JanDerogee/SerialSpeechSynthesizerSAM/documentation/Usermanual/instructional_drawings/Arduino_IDE_settings.jpg

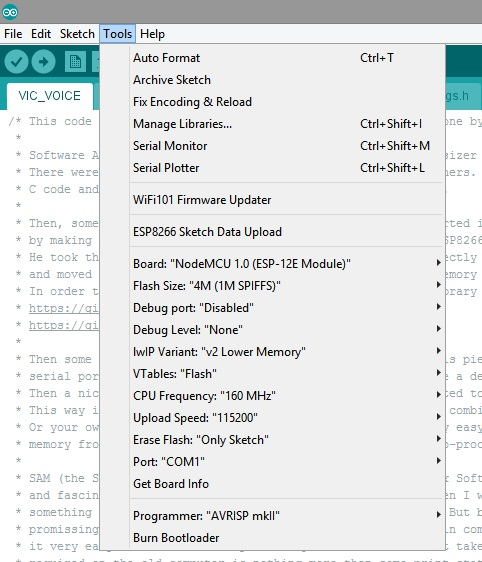
documentation/Usermanual/instructional_drawings/Arduino_IDE_settings.jpg
