JanDerogee/SerialSpeechSynthesizerSAM/Foto's/C64_setup.JPG

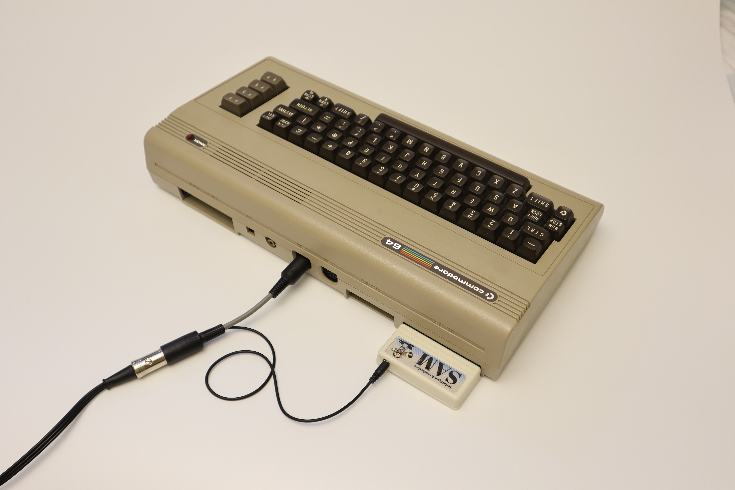
Foto's/C64_setup.JPG
