JanDerogee/SerialSpeechSynthesizerSAM/tools/readme.txt

drop the .jar file in the arduino tools directory

C:\Program Files (x86)\Arduino\tools\ESP8266FS\tool
