JanDerogee/SerialSpeechSynthesizerSAM/Foto's/DSC03284.JPG

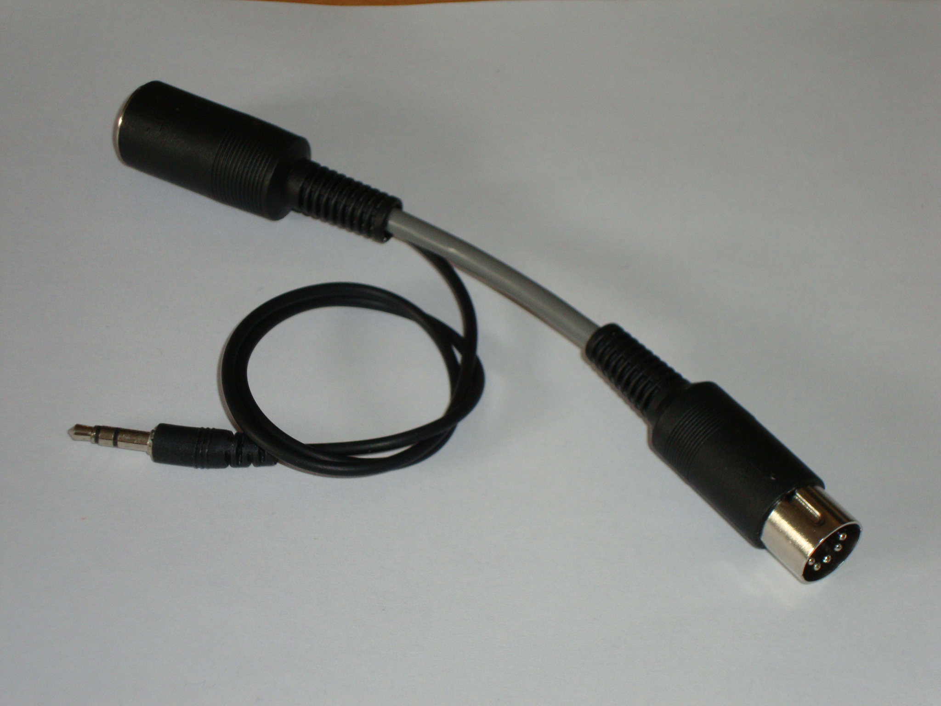
Foto's/DSC03284.JPG
