JanDerogee/SerialSpeechSynthesizerSAM/Foto's/SSSSAM_angled.JPG

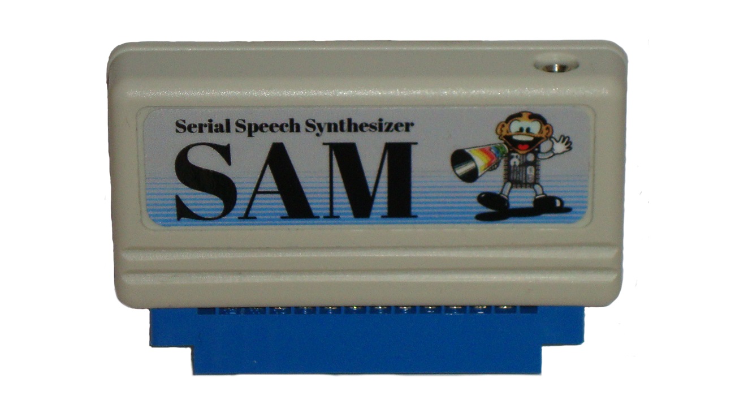
Foto's/SSSSAM_angled.JPG
