JanDerogee/SerialSpeechSynthesizerSAM/Foto's/SSSSAM_angled_side.JPG

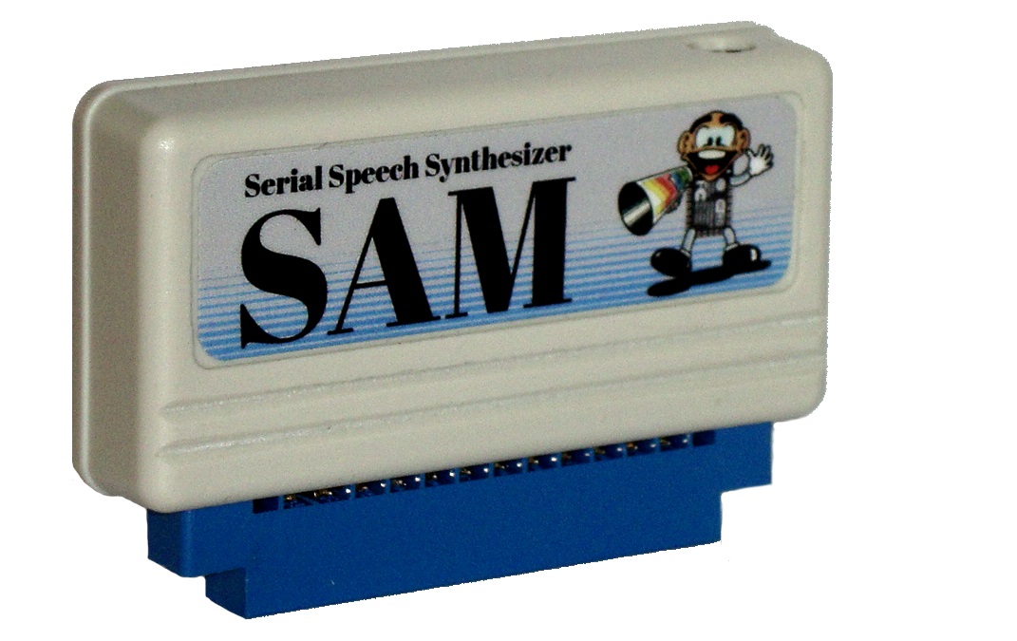
Foto's/SSSSAM_angled_side.JPG
