JanDerogee/SerialSpeechSynthesizerSAM/documentation/Usermanual/instructional_drawings/jumper_fw_programming.jpg

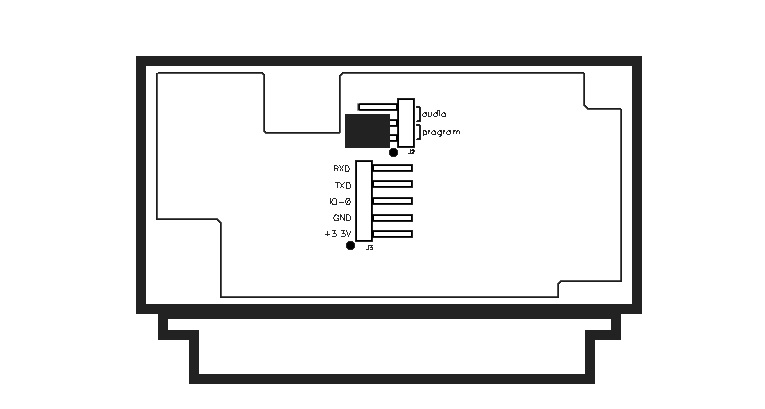
documentation/Usermanual/instructional_drawings/jumper_fw_programming.jpg
