JanDerogee/SerialSpeechSynthesizerSAM/documentation/Usermanual/instructional_drawings/schema.bmp

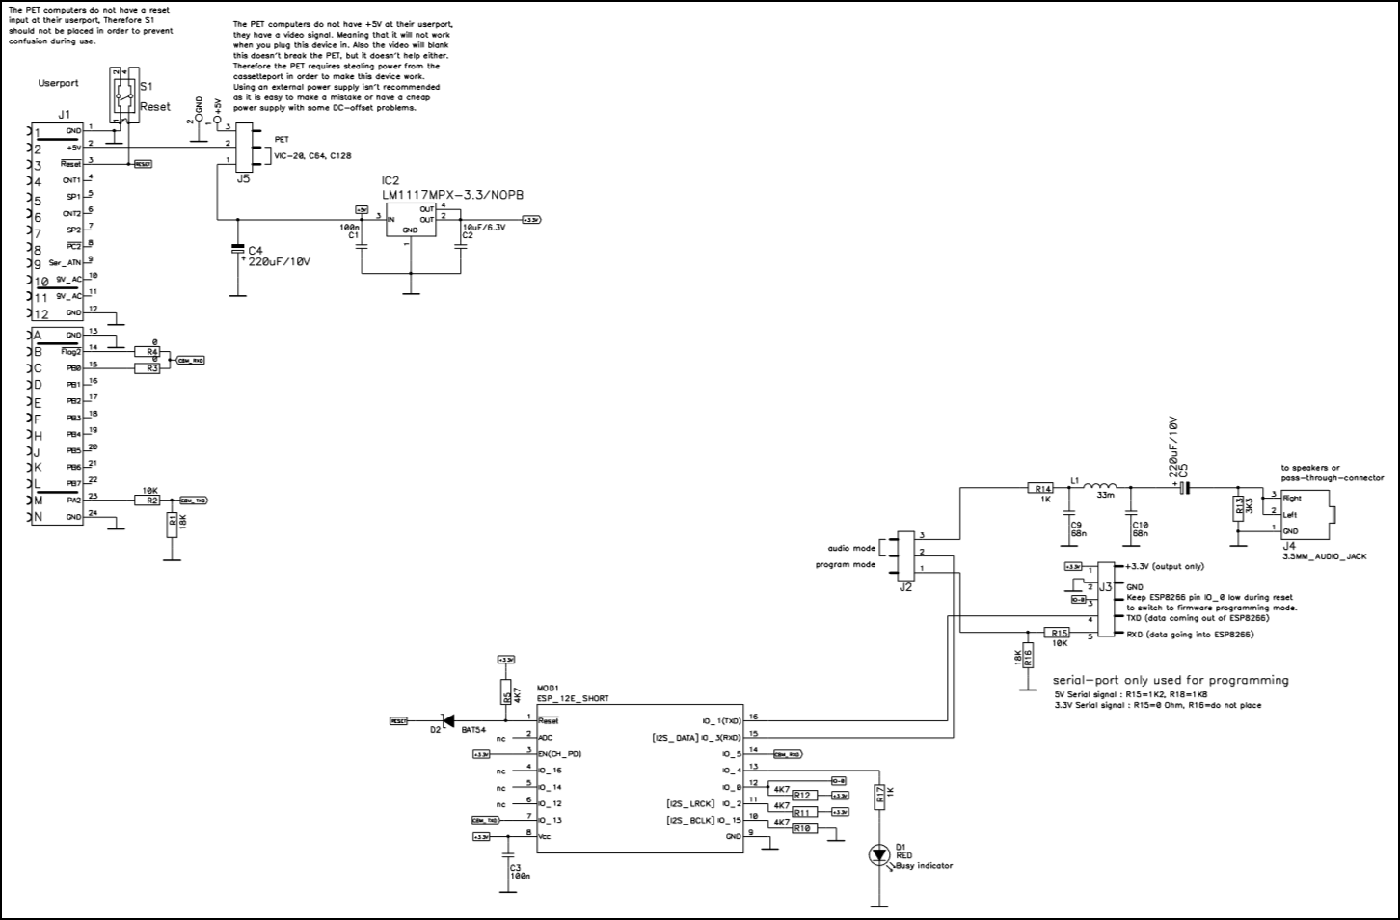
documentation/Usermanual/instructional_drawings/schema.bmp
