JanDerogee/SerialSpeechSynthesizerSAM/Foto's/VIC-20_setup.jpg

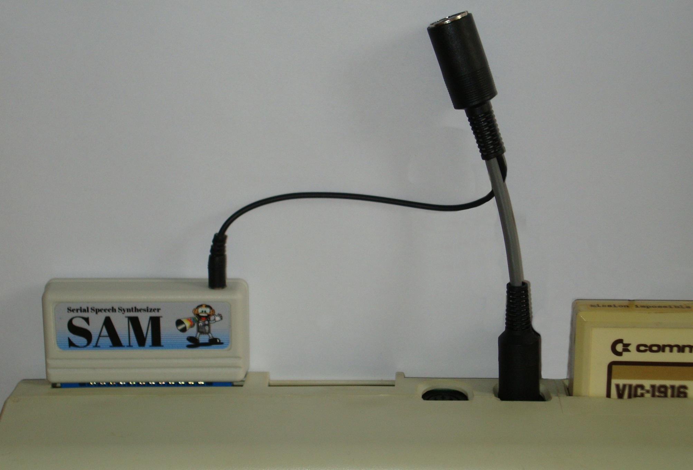
Foto's/VIC-20_setup.jpg
