JanDerogee/SerialSpeechSynthesizerSAM/Foto's/VIC-20_setup_2.JPG

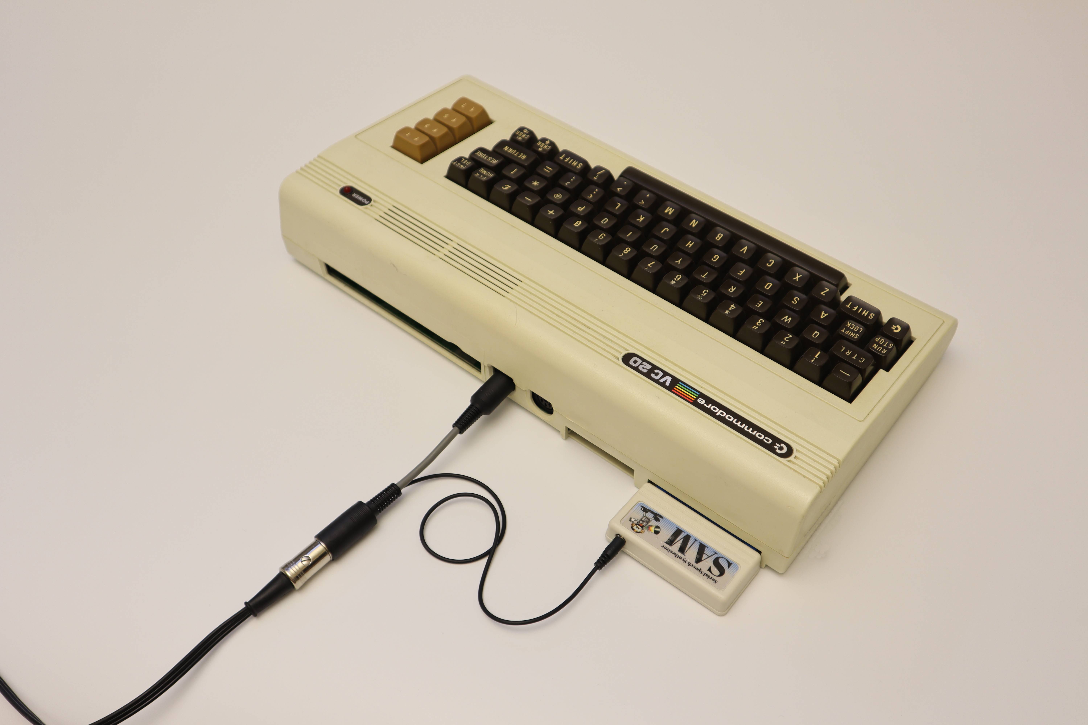
Foto's/VIC-20_setup_2.JPG
