JanDerogee/SerialSpeechSynthesizerSAM/hardware/pcb/v1.0/SSSSAM_PCB.pdf

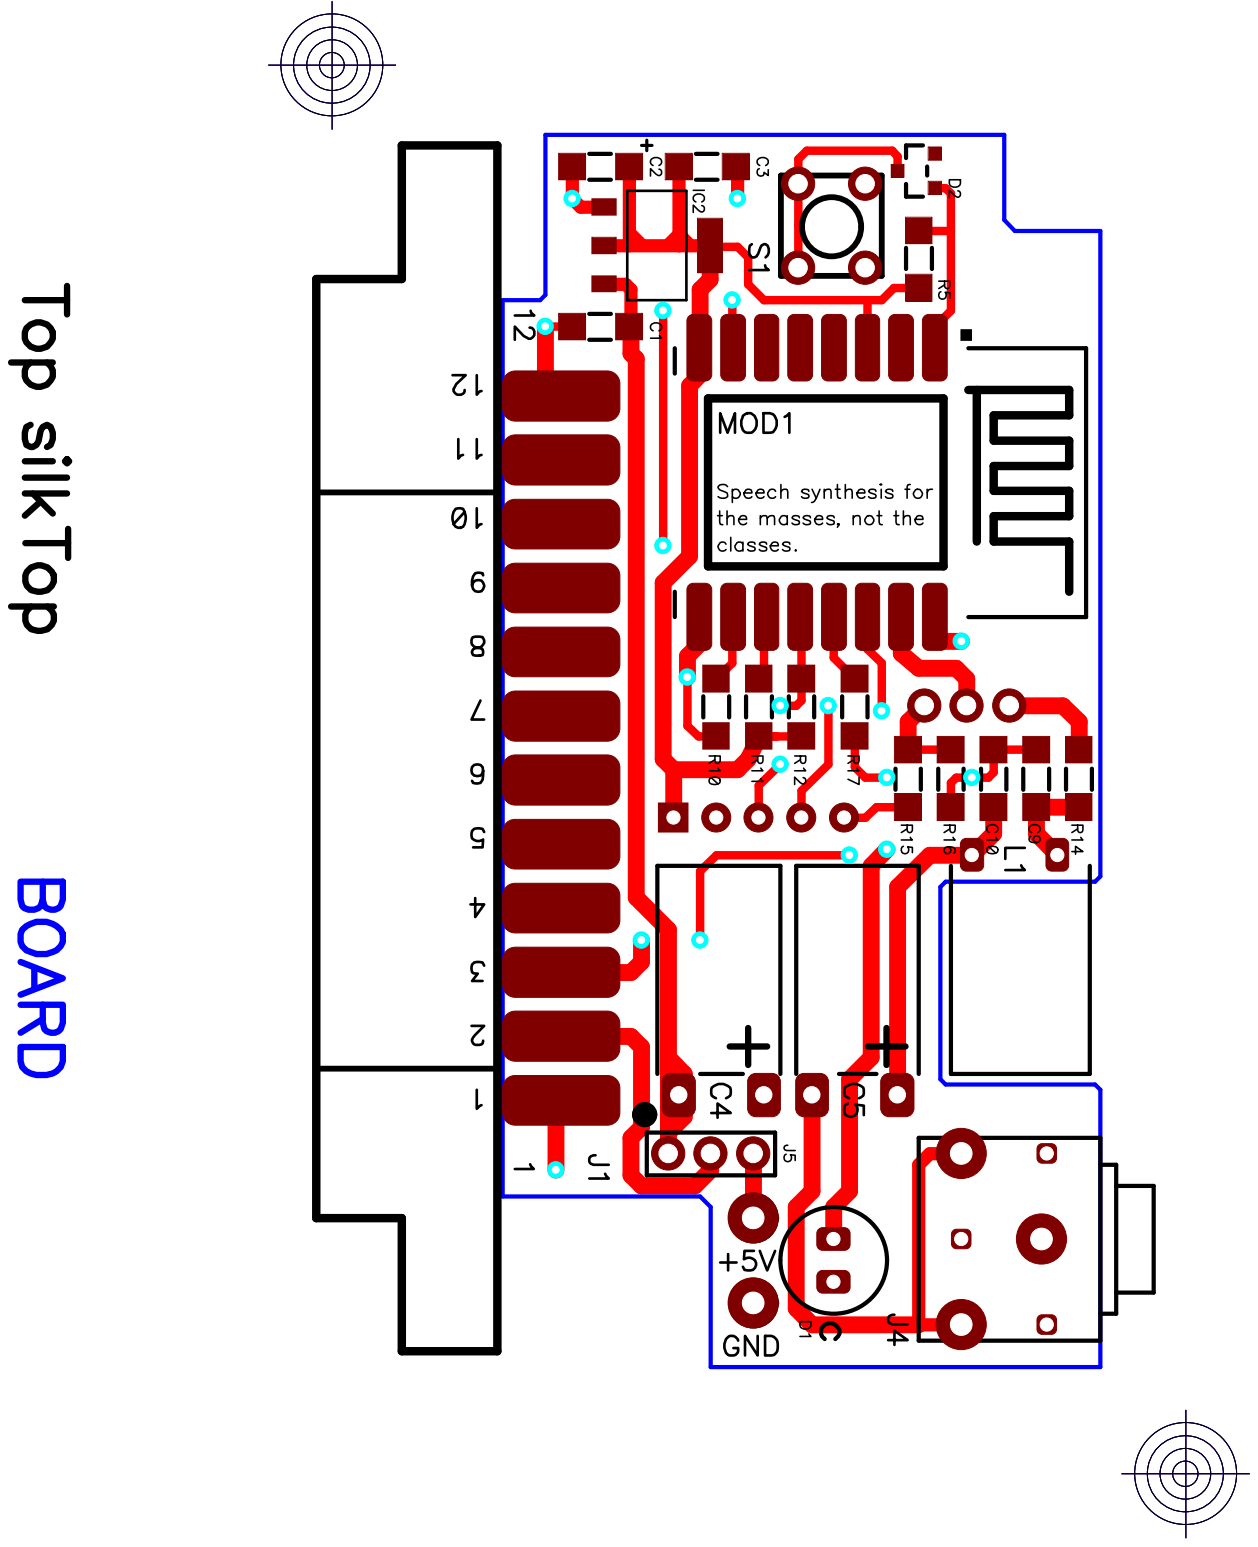
[picture p41: page 1]

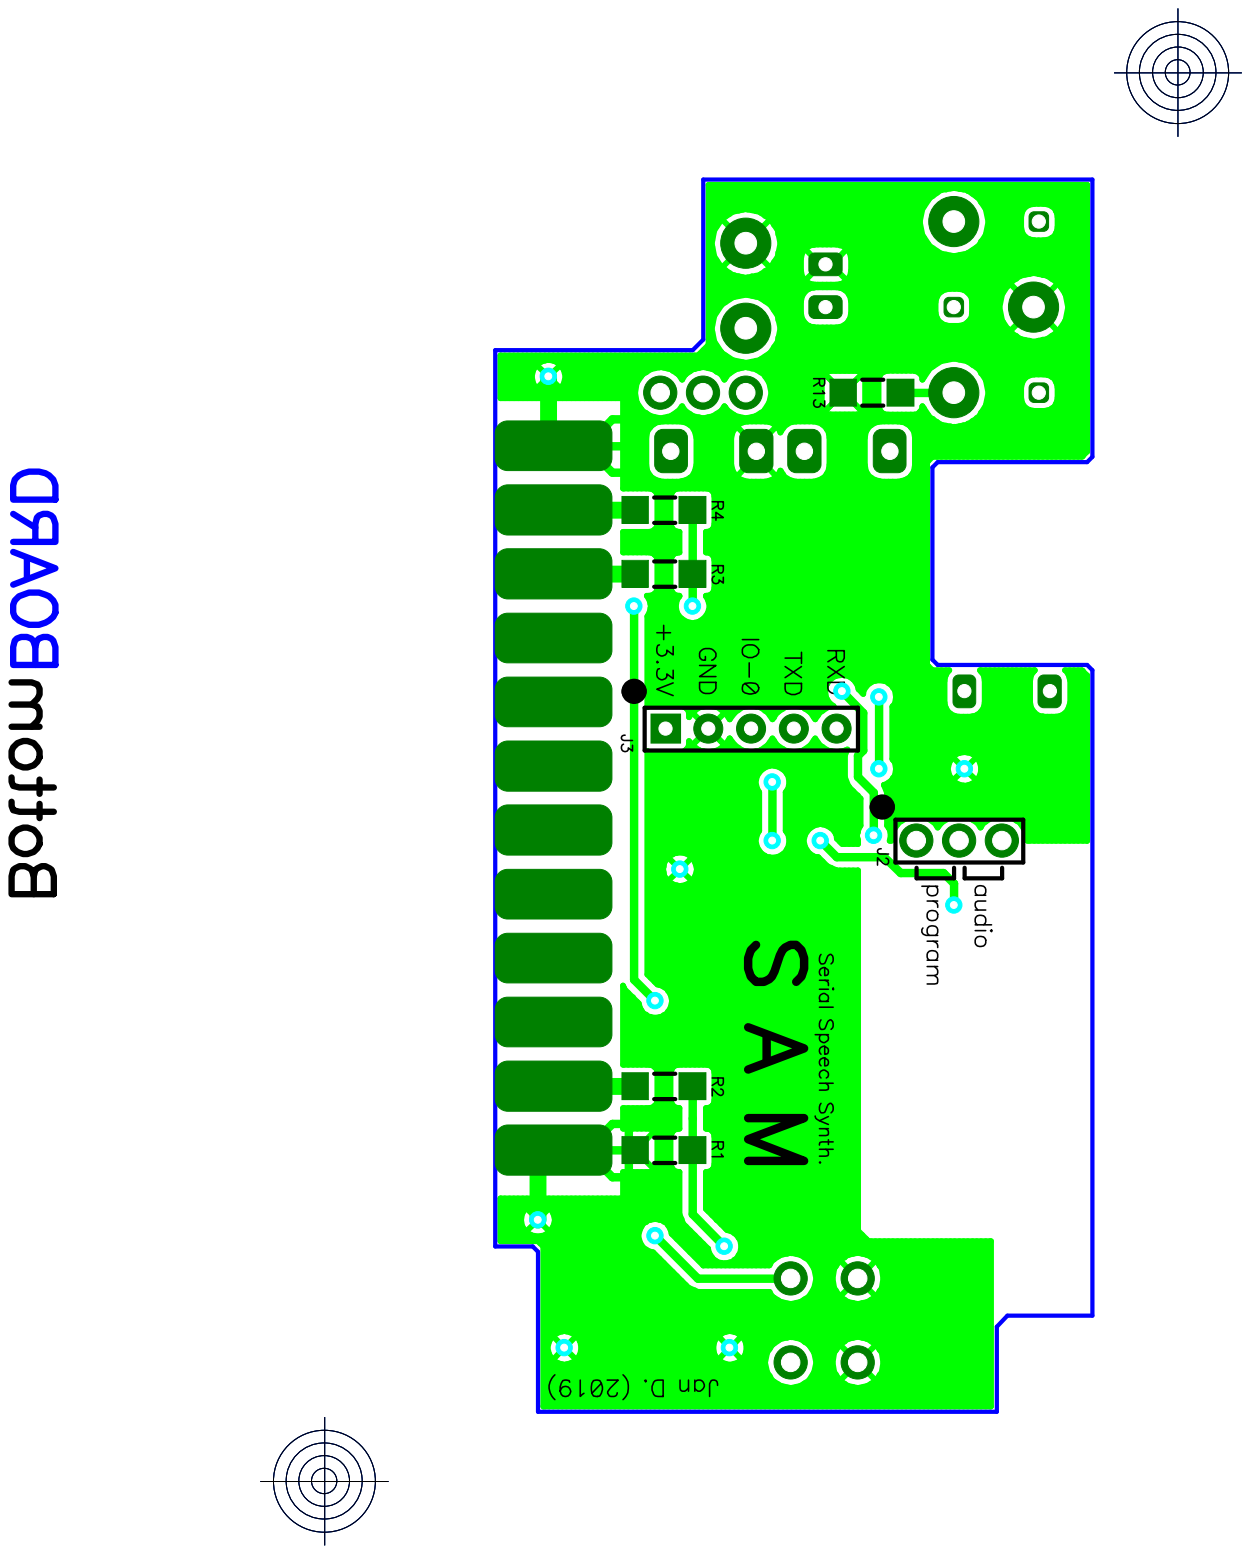
[picture p42: page 2]
