JanDerogee/SerialSpeechSynthesizerSAM/hardware/sch/v1.0/SSSSAM_schematic.pdf

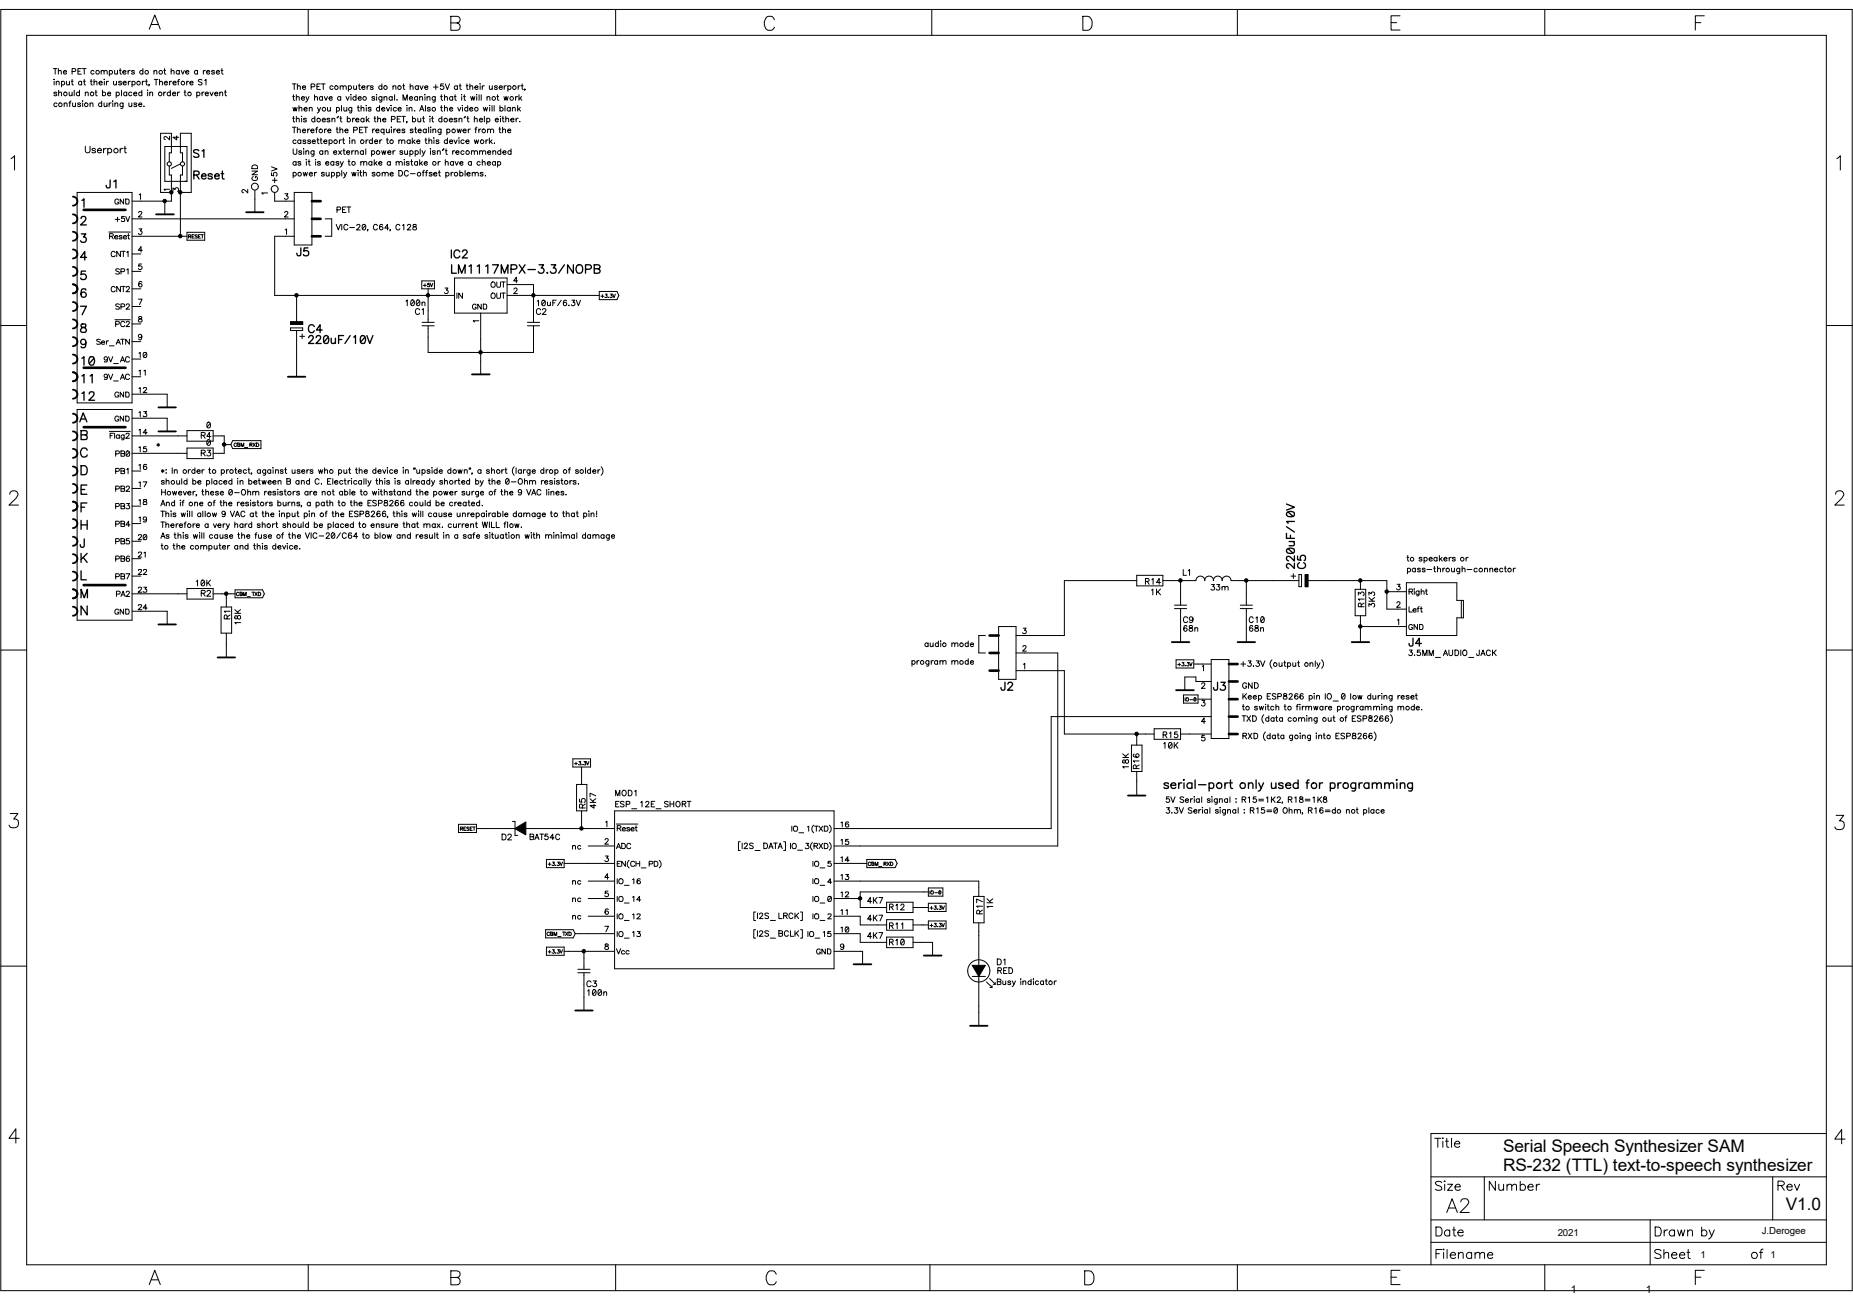
[picture p43: page 1]
J.Derogee

Serial Speech Synthesizer SAM
RS-232 (TTL) text-to-speech synthesizer
