JanDerogee/SerialSpeechSynthesizerSAM/(list of files, drawings)

Other design files:
hardware/pcb/v1.0/SSSSAM_v1.0.pcb
