JanDerogee/SerialSpeechSynthesizerSAM/source/SSSSAM/FSBrowser.h

#ifndef _FSBROWSER_H_
#define _FSBROWSER_H_

/*---------------------------------------------*/

void FSBrowser_init(void);
void FSBrowser_handle(void);

/*---------------------------------------------*/

#endif
